zhuoming34/mmw_uav/README.md

# Fast mmWave RF 3D-object reconstruction in Low-Visibility Environment via UAV Platform
2020-2021 Senior Design Project @UMB

### Texas Instruments mmWave Training Series
- https://training.ti.com/mmwave-training-series
