zhuoming34/mmw_uav/Hardware design/PCB/README.md

## Crazyflie v2 Template
crazyflie2-exp-template-electronics-master.zip

## 2019-2020 senior design PCB: flow deck connector
flow2_repin_gerber.zip

## 2020-2021 senior design PCB: multiranger deck connector
cf2-multirgr-connector-single.zip

## Mouser Library Loader for KiCAD
LibraryLoaderSetup2v49.msi.zip

## Wuerth FFC connector 8-pin 0.5mm footprint
Wuerth FFC connector 8pins 0.5mm/687108183722-pcb-part-libraries.zip
[https://www.mouser.com/ProductDetail/Wurth-Elektronik/687108183722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]

## Wuerth FFC jumper cable
[https://www.mouser.com/ProductDetail/Wurth-Elektronik/687608200002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]
