zhuoming34/mmw_uav/Scripts/Sample Synthesizer/README.md

# Sample Generator
- functions folder
- main.m
- variable_library.m
- variable_library_radar.m
- variable_camera.m

## main.m
## variable_library.m
## variable_library_radar.m
## variable_camera.m
