zhuoming34/mmw_uav/Scripts/CAD/README.md

# CAD Models
Showing 10 out of 38 CAD car models provided by Hawkeye.
The rest 28 CAD models can be found here: 
https://github.com/JaydenG1019/HawkEye-Data-Code
