zhuoming34/mmw_uav/Documentations/Algorithms/CFAR.pptx

## CFAR Constant False Alarm Rate Detection

08/27/2020

## Motivation

- Want to receive the reflected signals from targets, instead of clutter (environment and unwanted objects: ground, rain, buildings, trees, etc.)
- Want a dynamic threshold to filter out signals from clutters.
- By maintaining the threshold to have a constant false alarm rate (probability of false alarm) P_(fa)

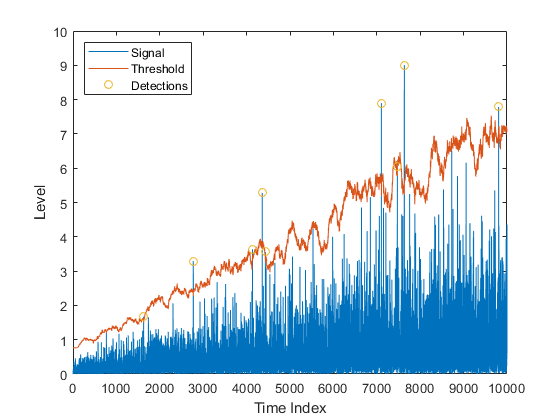
[picture p33: figure]

## Schematics

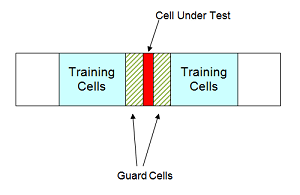
[picture p34: figure]
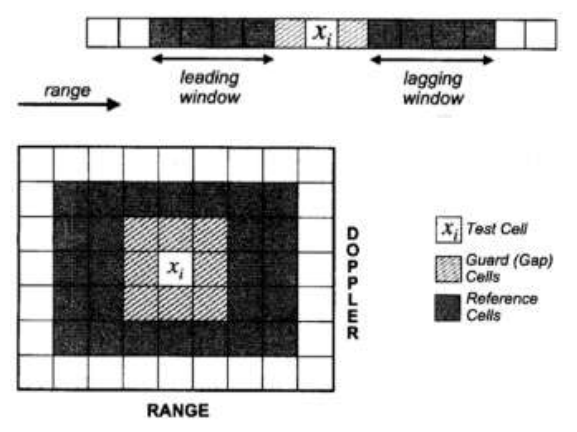
[picture p35: figure]

## Implementation

T = number of training cells on one side
G = number of guard cells on one side

1. Define number of training cells and guard cells
2. Sling the window one cell at a time across the complete FFT 1D array.
( total window size = 2*( T + G ) + 1 )
3. Sum the signal (noise) within all training cells
4. Average the sum above to determine the noise power estimate
5. Scale the noise estimate with an appropriate threshold factor to get a threshold
6. Measure signal in CUT (at T + G +1)
7. Compare against the threshold

## Equations

The detection threshold:
T=aP_n
where P_n is the noise power estimate,
a is the threshold factor, a function of fasle alarm rate P_(fa)
P_n =1/N∑_(m=1)^N x_m
where N is the number of training cells, x_m is the sample in each training cell.
Assuming the data passed into the detector is from a single pulse (i.e. no pulse integration), then the threshold factor:
a=N(P_(fa)^(−1/N) −1)

## phased.CFARDetector

- Assuming it is a square law detector with white Gaussian noise
- Important properties:
  - NumGuardCells
  - NumTrainingCells
  - Threshold factor
  - ProbabilityFalseAlarm
  - NumDetections
- Y = H(X,cutidx)
- [Y, TH] = H(X,cutidx)
  - X = input data, either a Mx1 column vector or MxN matrix
  - Cutidx = a length-D vector of indices of CUT
  - Y = detection results
  - TH = threshold

## Example

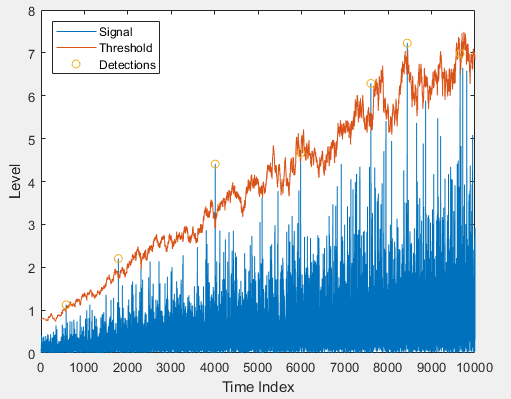
[picture p36: figure]
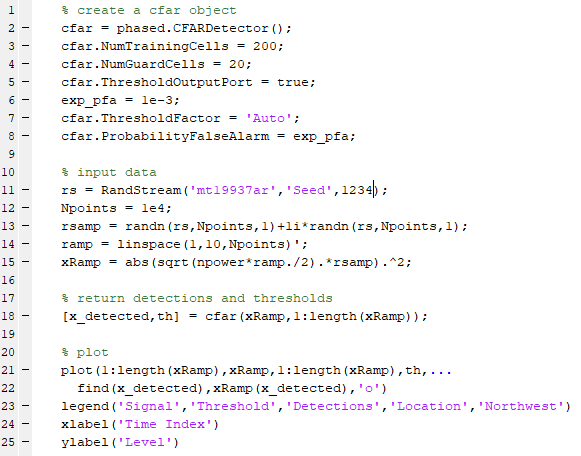
[picture p37: figure]
