zhuoming34/mmw_uav/Documentations/TI's mmWave/mmWave_Studio_Basic_Configurations.pdf

# Tutorial of Basic Configurations in Texas Instrument’s mmWave Studio with DCA1000EVM and IWR6843ISK

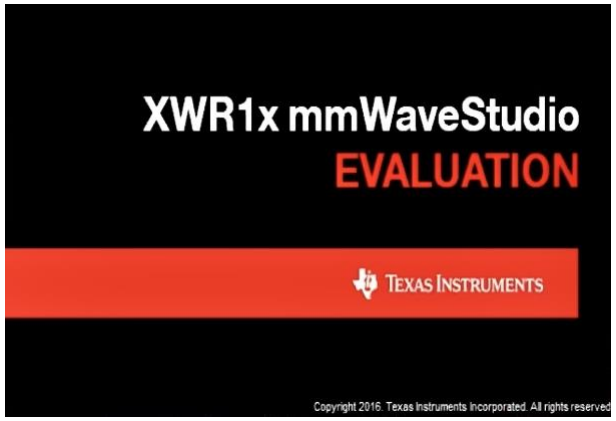
[picture p89: figure]

Detailed requirements and setups refer to the following video: DCA1000 Training Video : https://training.ti.com/dca1000-training-video Video for following steps: https://youtu.be/6t-P8zM8yU4

- Step A: Connection [Figures 1-6]
Follow the color-coded and numbered buttons to set up the connections
1. Reset control
2. Connect COM port for RS232 operations
3. Load BSS firmware
4. Load MSS firmware
5. SPI Connect
6. RF Power-up
- Step B: Static Configuration (StaticConfig) [Figures 7-9]
1. Select Tx2 (the 3rd transmitter) for IWR6843ISK to use MIMO configuration in azimuth direction
2. Set basic configuration
3. Set advanced configuration (default settings)
4. Click RF Init button (changes to RF Init Done after clicking it)
- Step C: Data Configuration (DataConfig) [Figures 10-12]
1. Set data path configuration (default settings)
2. Set clock configuration (default settings)
3. Set data configuration (default settings)
- Step D: Sensor Configuration (SensorConfig) [Figures 13-19]
1. In Profile section, change the Sample Rate (ksps) to 2047 and Ramp End Time (μs) to 133 (so that Bandwidth=3987.61MHz for a range resolution ≅ 4cm), then Set
2. In Chirp section, select Tx0 only with Start Chirp 0 and End Chirp 0, then Set
3. In Chirp section, select Tx1 only with Start Chirp 1 and End Chirp 1, then Set
4. In Chirp section, select Tx2 only with Start Chirp 2 and End Chirp 2, then Set
5. In Frame section, Start Chirp TX 0 and End Chirp TX 2 for TDM MIMO configuration. Set up desire number of chirps and frames with appropriate frame periodicity.

DutyCycle =

CℎirpDuration ∗ NumCℎirp ∗ NumTx

| FramePeriodicity | = (IdleTime + RampEndTime) ∗ NumCℎirp ∗ NumTx
| | FramePeriodicity
Example:
Idle Time = 100 μs, | Ramp End Time = 133 μs, | Periodicity = 180 ms
Number of Transmitters = 3 (Tx0, Tx1, Tx2), | Number of Chirp(No of Chirp Loops) = 128,
| DutyCycle =

(100μs + 133μs) ∗ 128 ∗ 3
| | 180ms ≅ 49.7%
6. At the left-most section, click the Set Up DCA1000 button to open the RFDataCaptureCard window
7. Click the Connect, Reset and Configure button to setup the DCA100EVM
- Step E: Data Capture and Post Processing (SensorConfig – Capture and Post Processing Section) [Figures 20-22]
1. Browser and select the .bin file to save captured data
2. DCA100 ARM
3. Trigger Frame
4. PostProc (post processing)

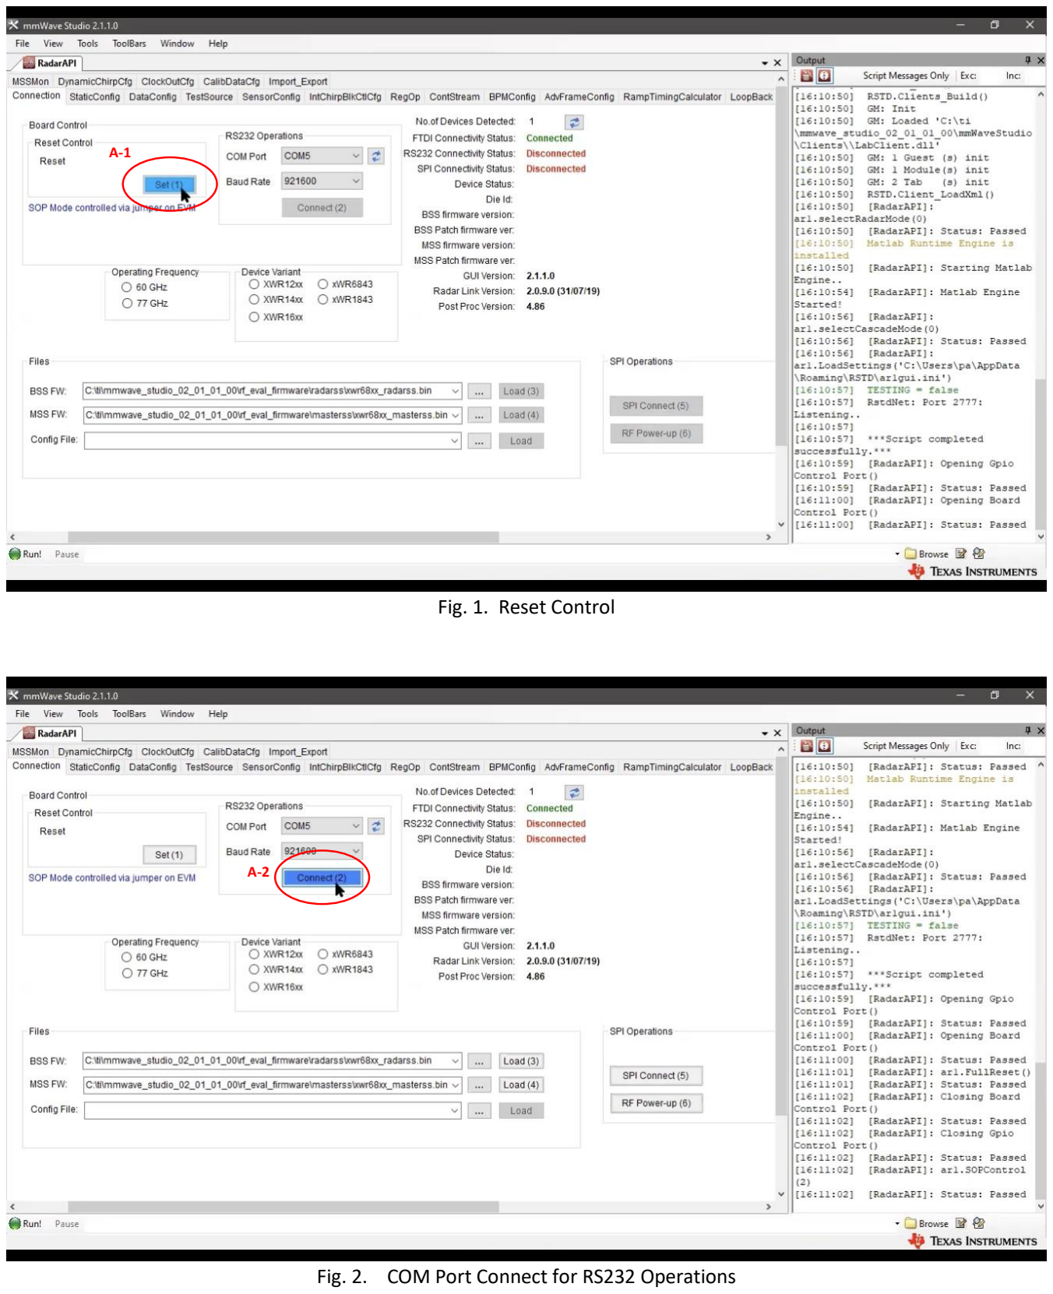
[picture p90: page 3]

Fig. 1. Reset Control

Fig. 2. COM Port Connect for RS232 Operations

A-1

A-2

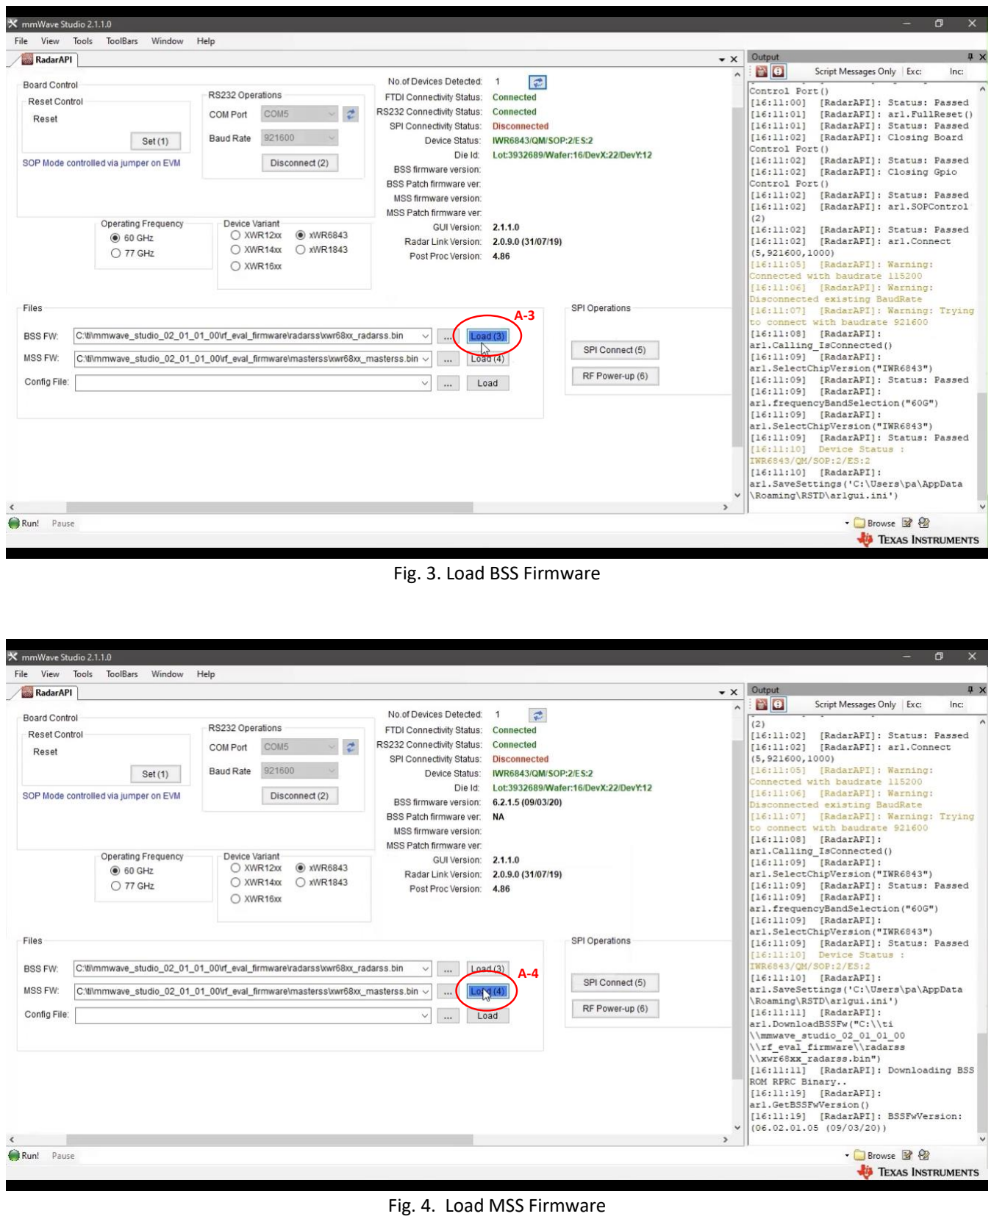
[picture p91: page 4]

Fig. 3. Load BSS Firmware

Fig. 4. Load MSS Firmware

A-3

A-4

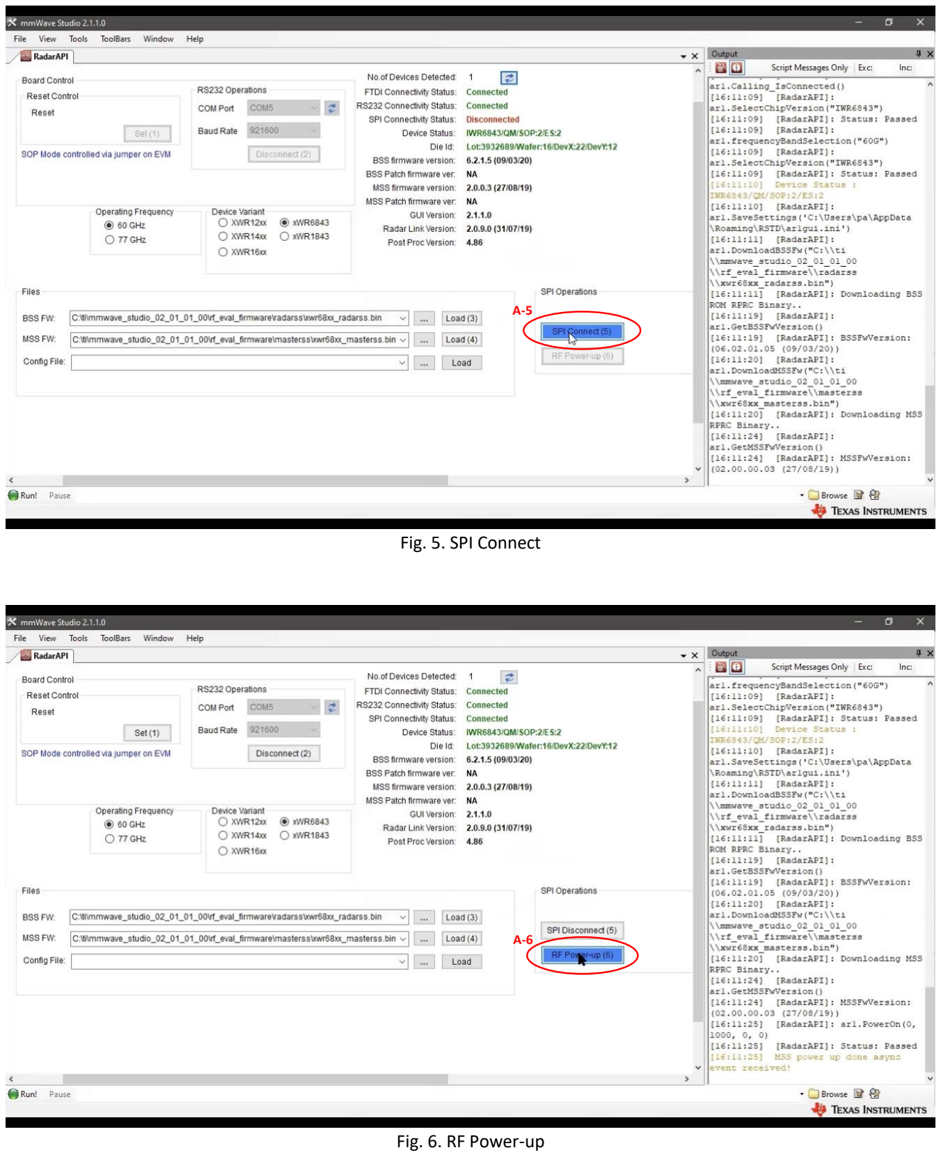
[picture p92: page 5]

Fig. 5. SPI Connect

Fig. 6. RF Power-up

A-5

A-6

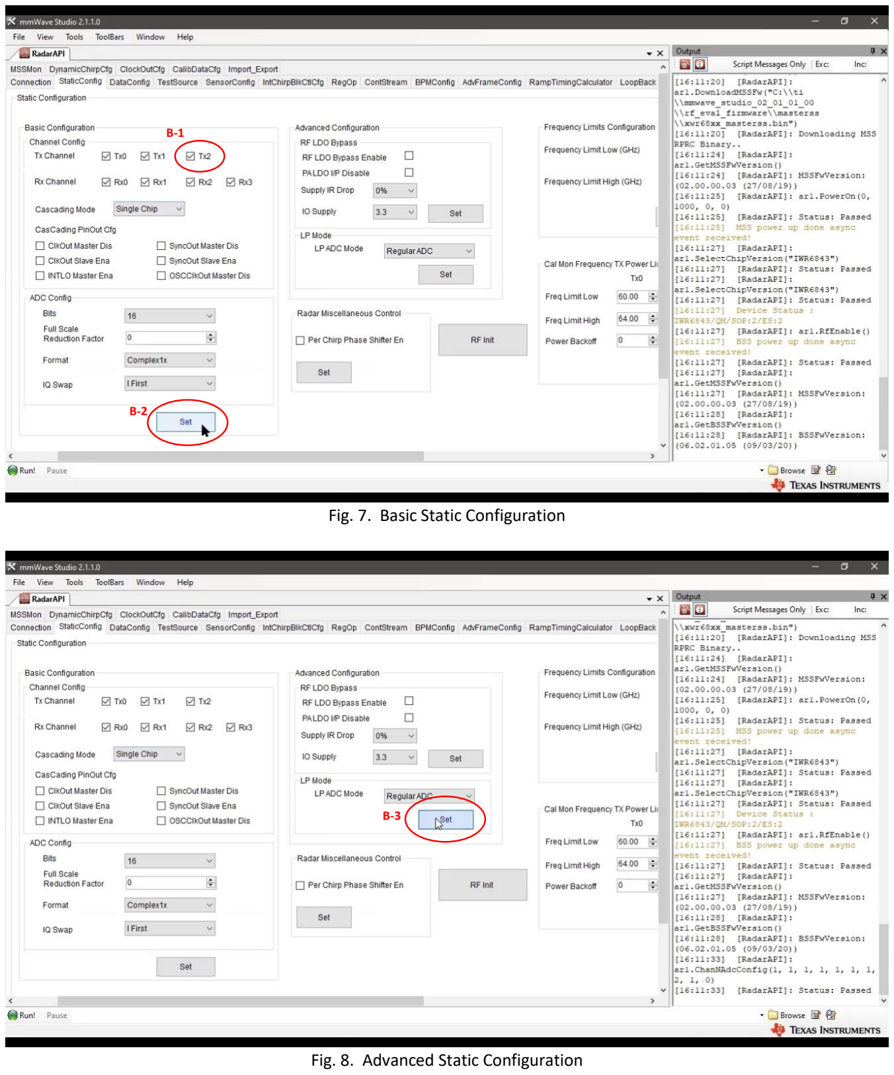
[picture p93: page 6]

Fig. 7. Basic Static Configuration

Fig. 8. Advanced Static Configuration

B-1

B-2

B-3

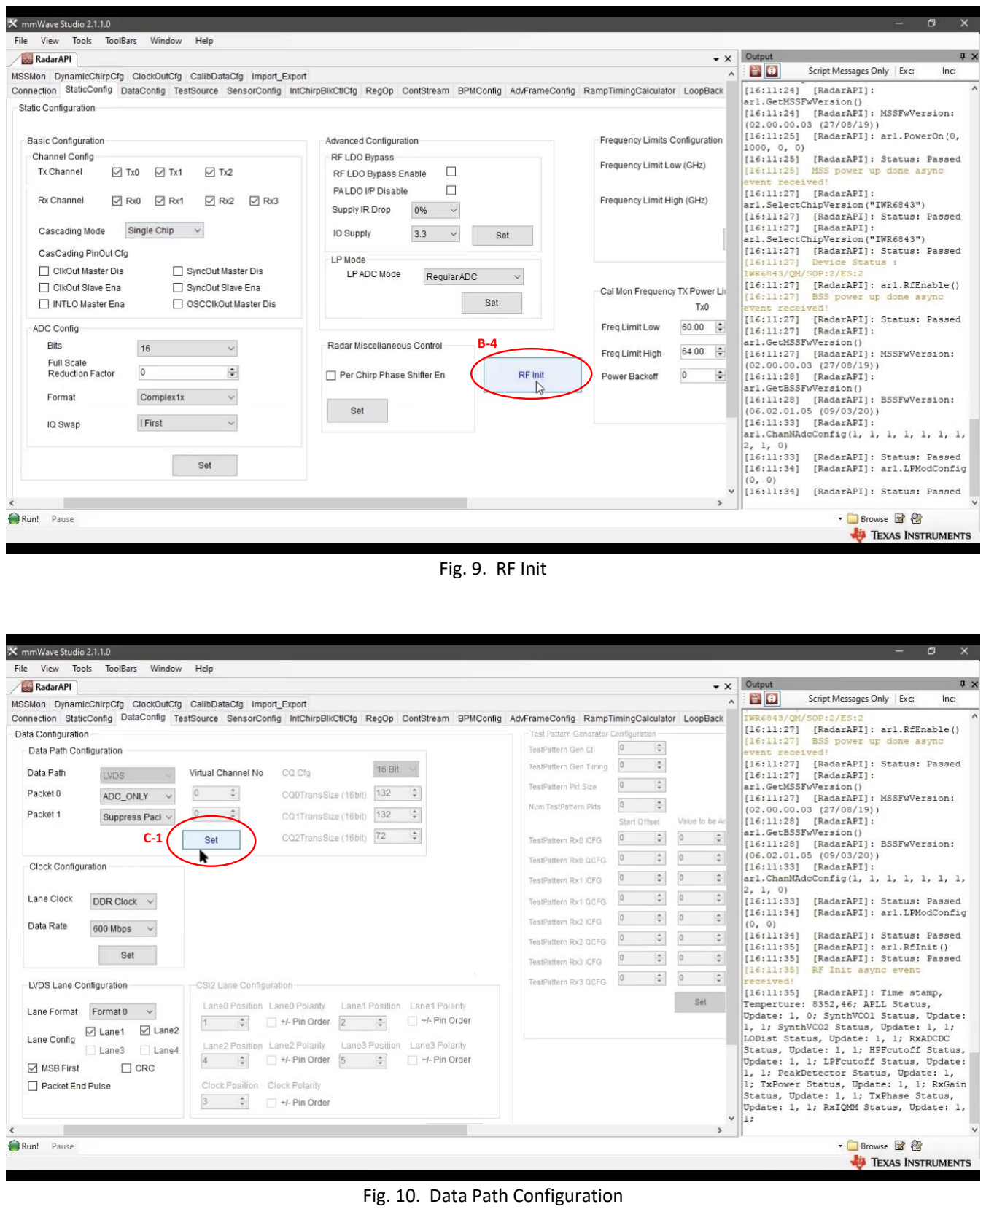
[picture p94: page 7]

Fig. 9. RF Init

Fig. 10. Data Path Configuration

B-4

C-1

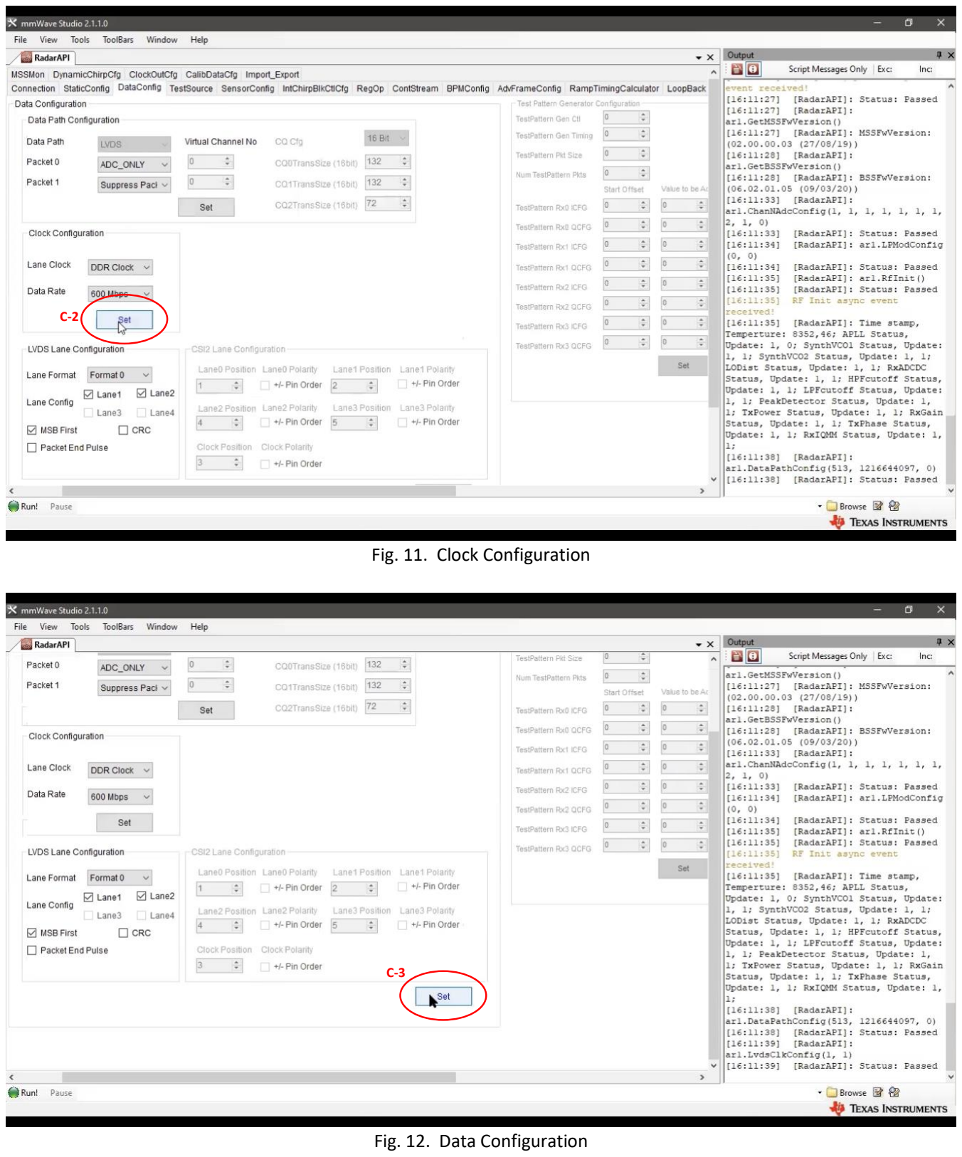
[picture p95: page 8]

Fig. 11. Clock Configuration

Fig. 12. Data Configuration

C-2

C-3

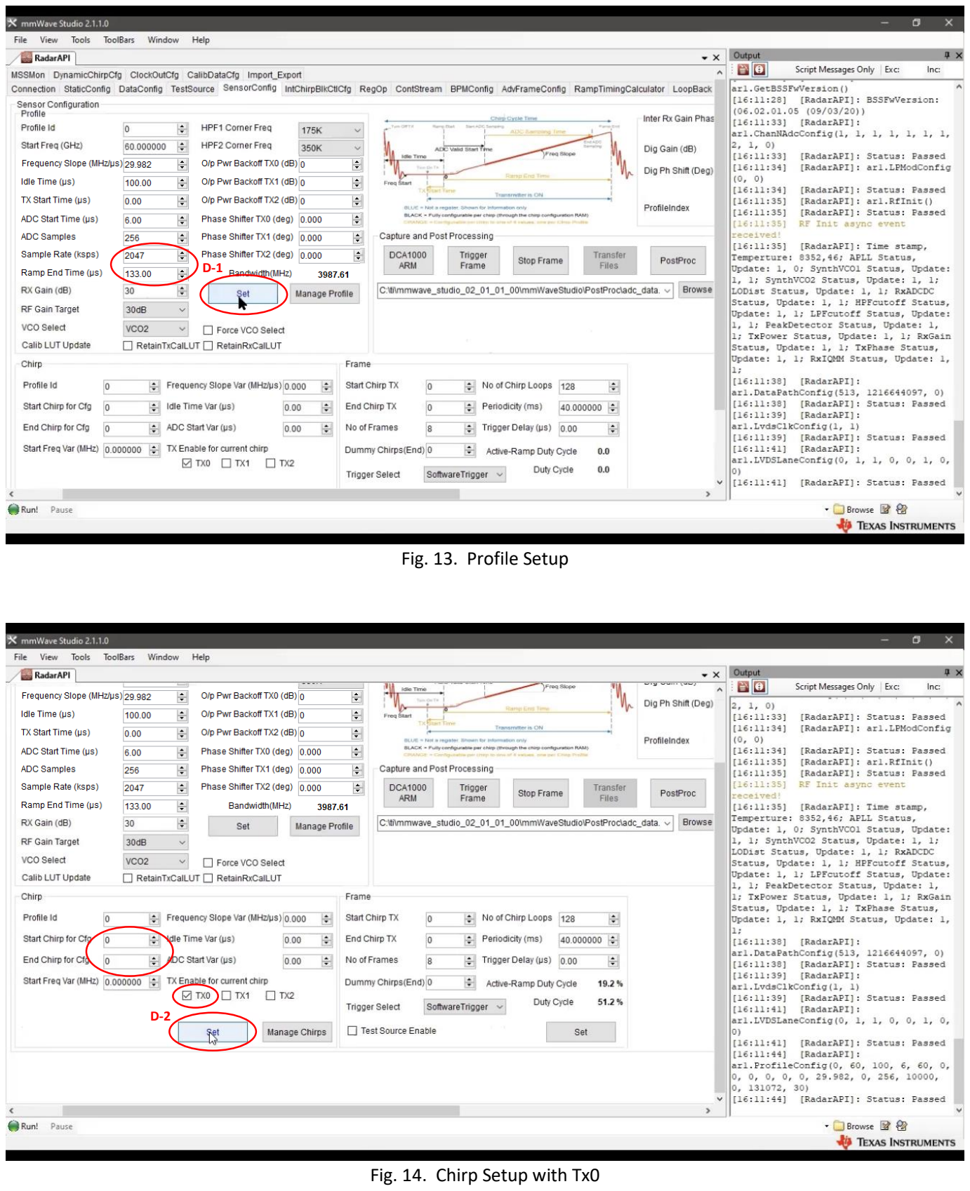
[picture p96: page 9]

Fig. 13. Profile Setup

Fig. 14. Chirp Setup with Tx0

D-1

D-2

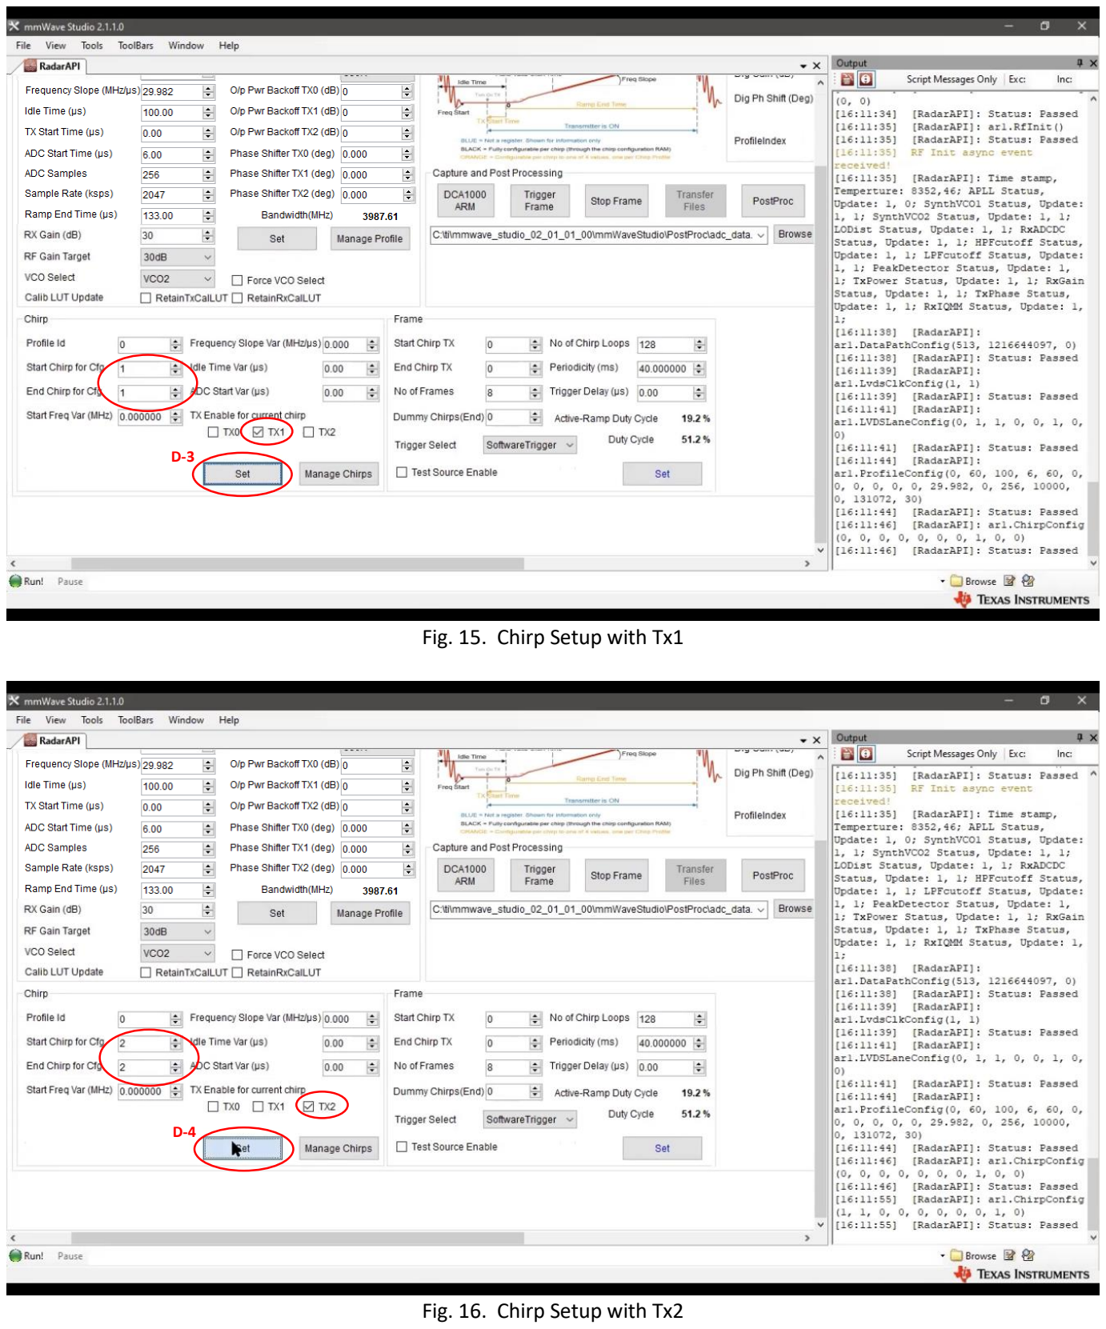
[picture p97: page 10]

Fig. 15. Chirp Setup with Tx1

Fig. 16. Chirp Setup with Tx2

D-3

D-4

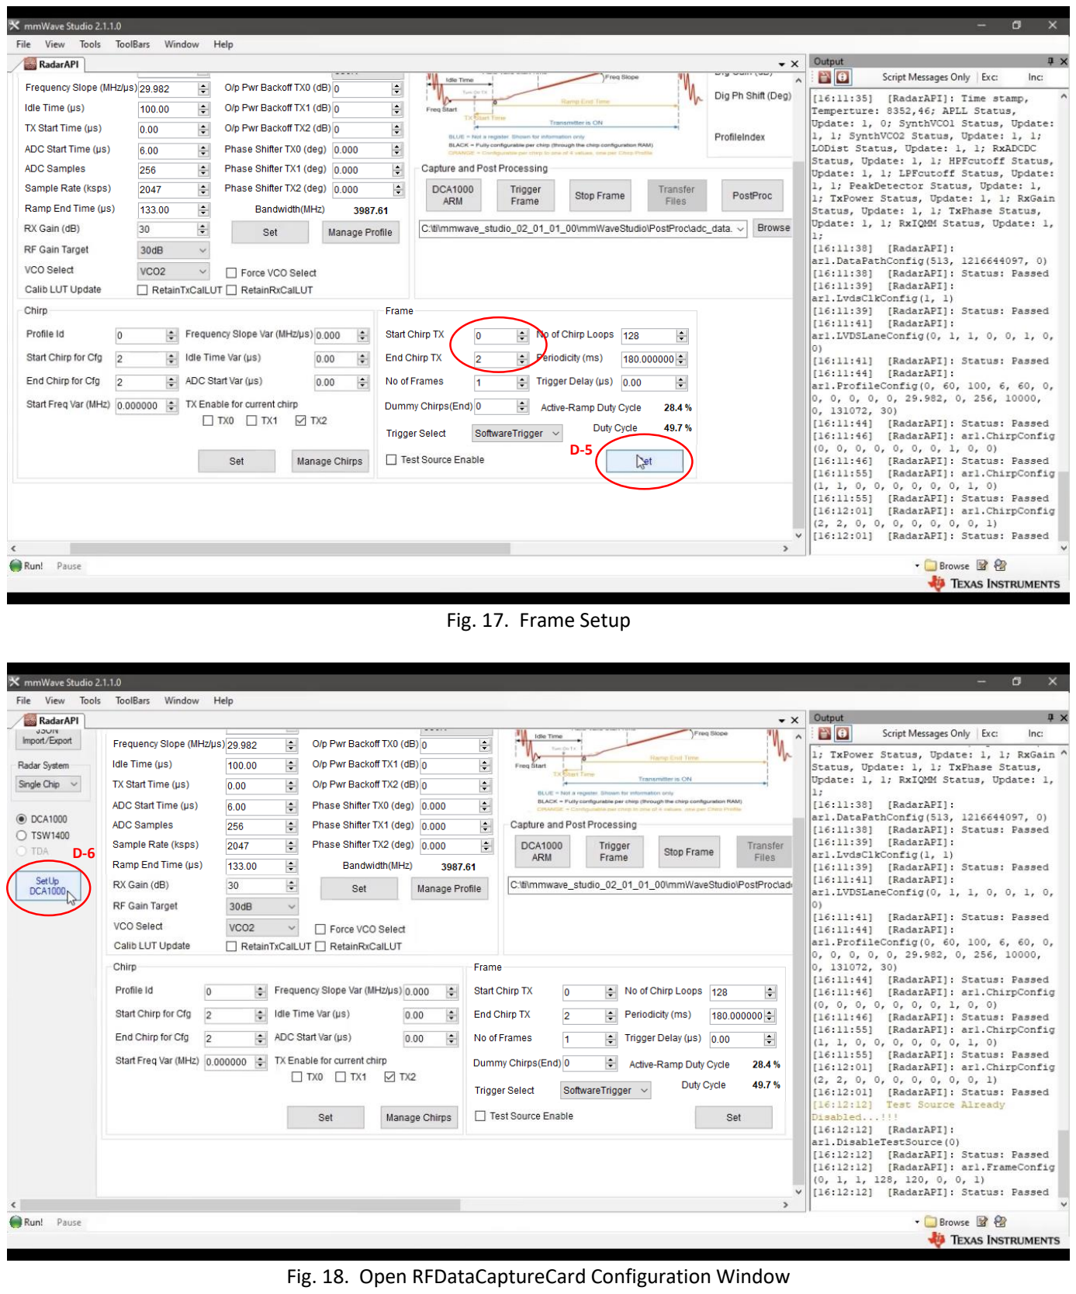
[picture p98: page 11]

Fig. 17. Frame Setup

Fig. 18. Open RFDataCaptureCard Configuration Window

D-5

D-6

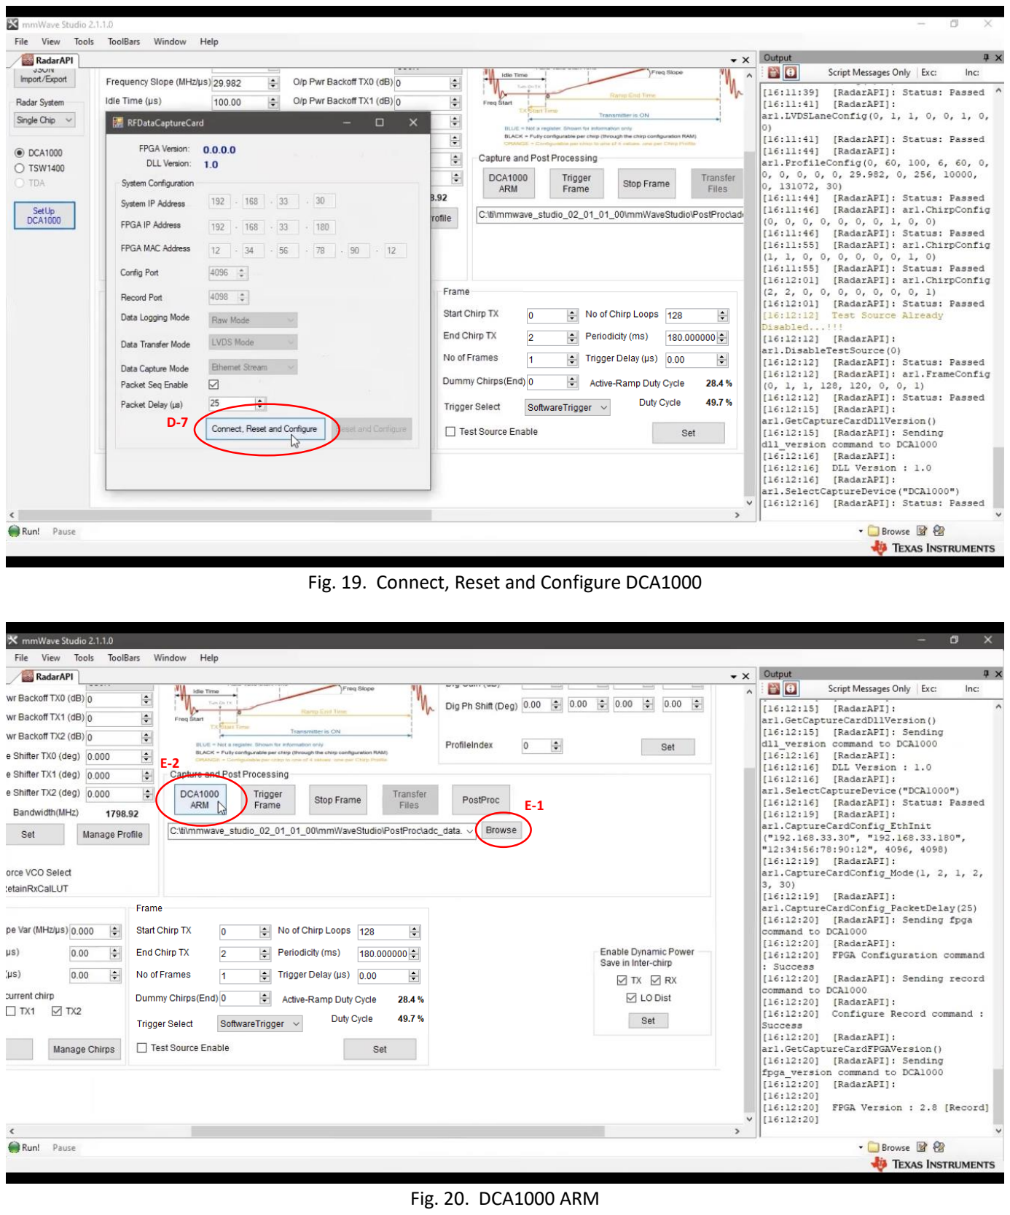
[picture p99: page 12]

Fig. 19. Connect, Reset and Configure DCA1000

Fig. 20. DCA1000 ARM

D-7

E-1

E-2

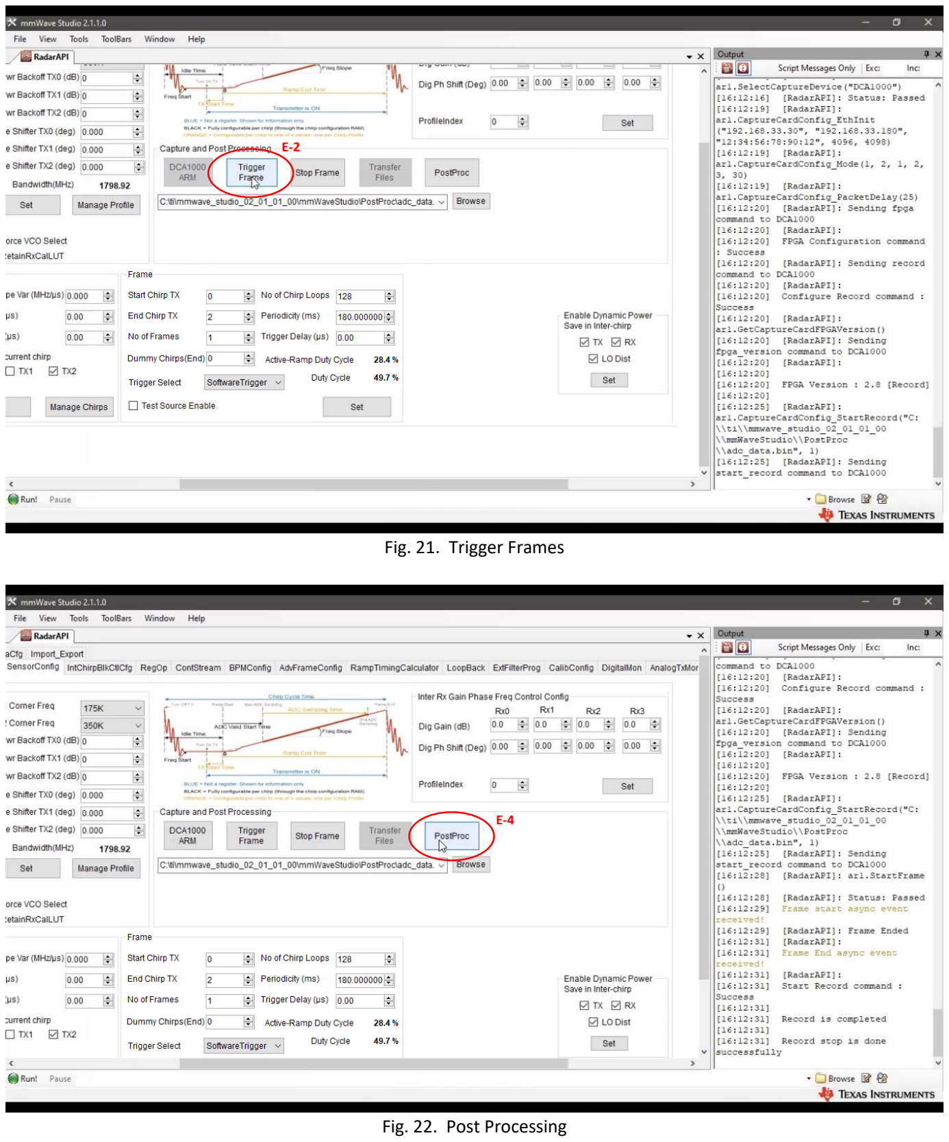
[picture p100: page 13]

Fig. 21. Trigger Frames

Fig. 22. Post Processing

E-2

E-4
