zhuoming34/mmw_uav/Documentations/Meeting Notes/ENGIN492/week#3_0210.pdf

ENGIN492, Senior Design Weekly Meeting #3

Meeting Minutes
02/10/2021 | 15:30 – 16:00
CM/TM: | Dr. Honggang Zhang
Students: | Zhuoming Huang, Alinson Sanquintin, Lucas Lomba
- Agenda
1. Confirming DIY slides Design
- Notes
1. Radar calibration
2. 3D prints for the customized slider (order it from Maker Space ASAP, forward the notices to Prof. Zhang)
3. PCB design and order (confirm with Lucas)
- Follow-up
