zhuoming34/mmw_uav/Documentations/Meeting Notes/ENGIN492/week#9_0324.pdf

ENGIN492, Senior Design Weekly Meeting #9

Meeting Minutes
03/24/2021 | 15:30 – 16:10
CM/TM: | Dr. Honggang Zhang
Students: | Zhuoming Huang, Alinson Sanquintin
- Agenda
1. Verification tests (continued)
- Notes
1. 3D point cloud given by depth camera is not accurate all the time, we may use accurate measurement of distance by the radar sensor.
2. Conduct drone stabilization test outdoor, followed by flight control accuracy test indoor.
- List of Actions
- Preliminary Agenda for Next Meeting
