zhuoming34/mmw_uav/Documentations/Meeting Notes/ENGIN491/week#16_minutes_1221.pdf

Senior Design Weekly Meeting #16

Meeting Minutes
12/21/2020 | 13:30 – 14:45
CM/TM: | Dr. Honggang Zhang
Students: | Zhuoming Huang, Yue Sun, Alinson Sanquintin, Lucas Lomba
- Agenda
1. CAD modeling tools
- Notes
1. Research on FreeCAD
a. representing/converting CAD models in the form of point-cloud
b. https://www.freecadweb.org/
2. Winter break
a. Resuming meetings on 1/4/2021, 1pm
