zhuoming34/mmw_uav/Documentations/Meeting Notes/ENGIN491/week#4_notes.pdf

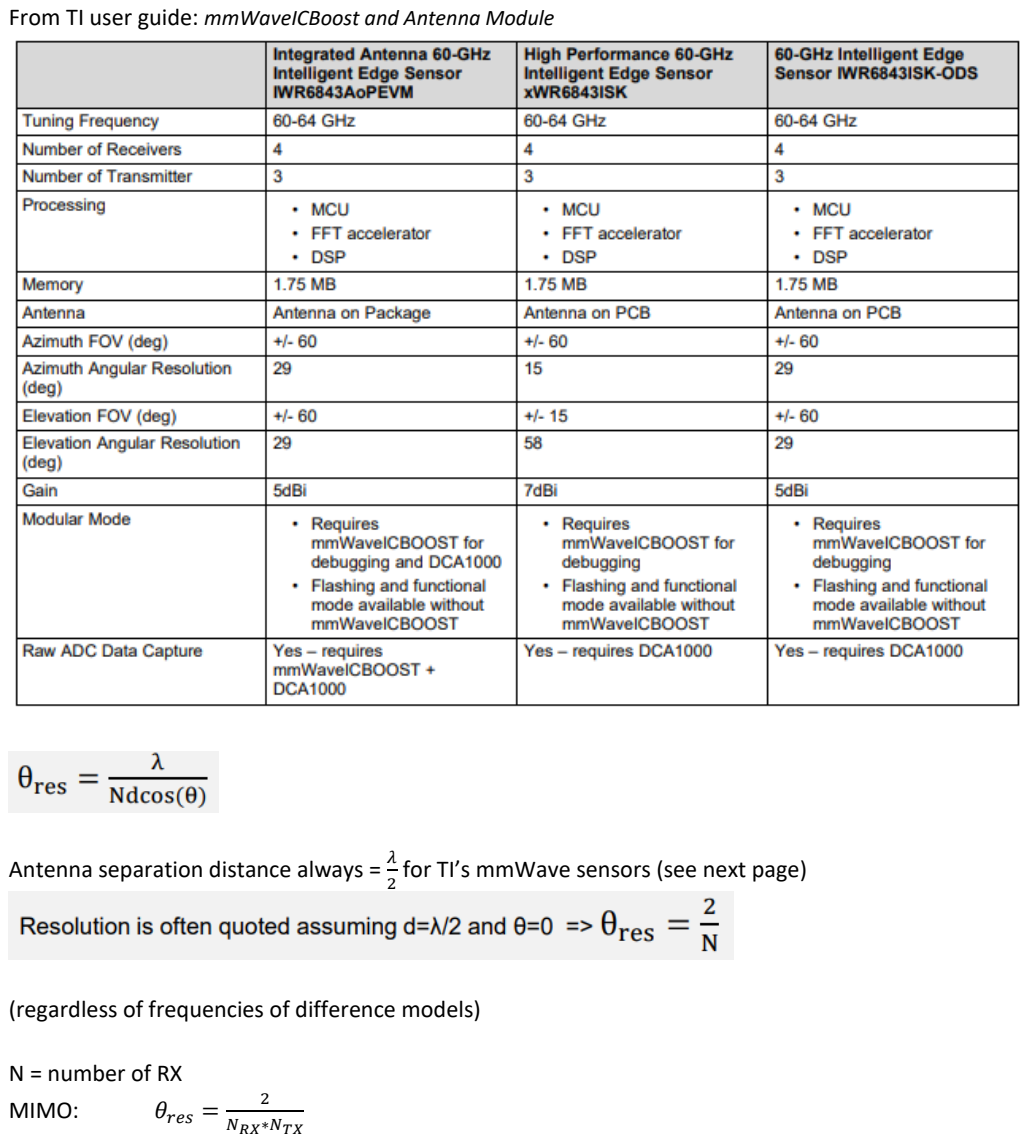
[picture p103: page 1]

From TI user guide: mmWaveICBoost and Antenna Module

Antenna separation distance always = λ
2

for TI’s mmWave sensors (see next page)

(regardless of frequencies of difference models)

N = number of RX
MIMO: | θres =

2

NRX∗NTX

(

(

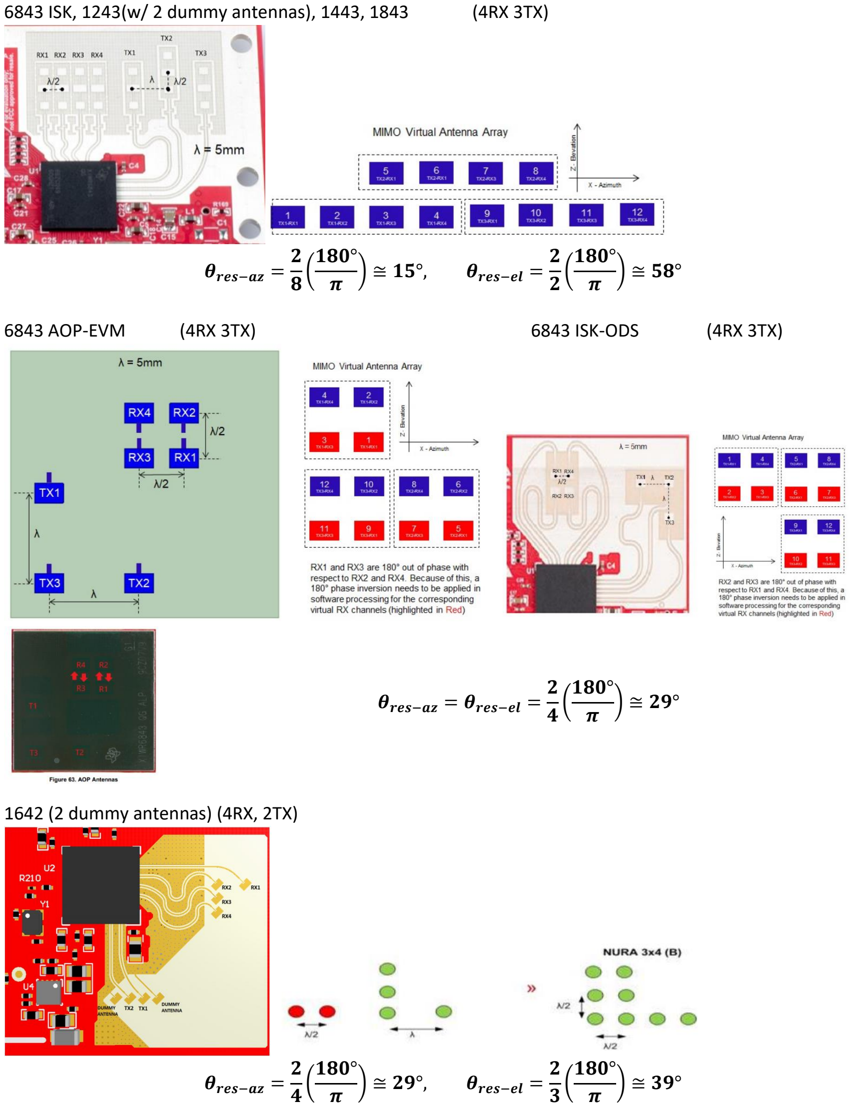
[picture p104: page 2]

6843 ISK, 1243(w/ 2 dummy antennas), 1443, 1843 | (4RX 3TX)

θres−az =

2
8

180°
π

) ≅ 15°, θres−el =

2
2

180°
π

) ≅ 58°

6843 AOP-EVM | (4RX 3TX) | 6843 ISK-ODS | (4RX 3TX)

θres−az = θres−el =

2
4

(

180°
π

) ≅ 29°

1642 (2 dummy antennas) (4RX, 2TX)

θres−az =

2
4

(

180°
π

) ≅ 29°, θres−el =

2
3

(

180°
π

) ≅ 39°
