zhuoming34/mmw_uav/Documentations/Algorithms/Root-MUSIC.pptx

## Root-MUSIC, Range, and Doppler Estimations

09/01/2020

## MATLAB Objects and Functions

- Phase Array System Toolbox:
  - Objects/classes:
    - phased.RootMUSICEstimator
    - phased.RangeDopplerResponse
    - phased.RangeEstimator
    - phased.DopplerEstimator
- Signal Processing Toolbox
  - Function:
    - rootmusic()

## phased.RootMUSICEstimator

- Multiple Signal Classification DoA Estimation
- Properties
  - Important:
    - SensorArray: ULA (or UCA)
    - PropagationSpeed: speed of light or user specified
    - OperatingFrequency: central frequency of radar fc
    - NumSignalsSource: ‘Property’
    - NumSignals: #signal received by ULA (default: 1)
  - Others:
    - NumSignalsMethod: ‘AIC’ or ‘MDL’ (Akaike Information Criterion or Minimum Description Length Criterion)
    - SpatialSmoothing: 0
    - ForwardBackwardAveraging: false

## phased.RootMUSICEstimator

- H = phased.RootMUSICEstimator()
- ANG = H(x)
  - For ULA use
  - Estimates the direction of arrival (DOA’s) from a signal x
  - X is a matrix whose columns correspond to the signal channels.
  - ANG is a row vector of estimated broadside angles in degrees.
- ANG = H(x, ElAng)
  - For UCA use
  - ElAng = elevation angles of signals

## Example

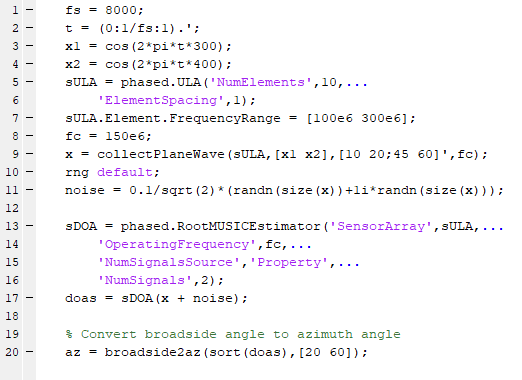
[picture p105: figure]
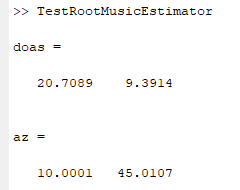
[picture p106: figure]

## phased.RangeDopplerResponse

- Calculate filtered response to range data, perform peak detection, resolve range-Doppler coupling.
- Important Properties (for FFT):
  - Range Method: FFT
  - Signal propagation speed
  - Sampling rate
  - Sweep slope
  - Range FFT Length
  - Doppler FFT Length
  - Operating Frequency
  - Doppler Output: frequency or Speed
- [resp,rnggrid,dopgrid] = H(x)
- plotResponse(H,x)

## phased.RangeEstimator

- Important Properties:
  - RMS Resolution
  - Noise Power source: ‘input port’ to enable input to step functions
  - Cluster Input Port: true to enable input
  - Variance output port: true to enable output

## phased.RangerEstimator

- H = phased.RangerEstimator()
- rngest = H(resp,rnggrid,detidx)
- [rngest,rngvar] = H(resp,rnggrid,detidx,noisepower)
- [rngest,rngvar] = H(resp,rnggrid,detidx,clusterids)
- [rngest,rngvar] = H(resp,rnggrid,detidx,clusterids,noisepower)
- rnggrid = units for range dimension of the response data cube
- detidx = detection position index

## phased.DopplerEstimator

- Important Properties
  - Num pulses: number of pulses in doppler-processed waveform
  - Noise power source
  - Cluster Input port
  - Variance output port

## phased.DopplerEstimator

- H = phased.DopplerEstimator()
- dopest = H(resp,dopgrid,detidx)
- [dopest,dopvar] = H(resp,dopgrid,detidx,noisepower)
- [dopest,dopvar] = H(resp,dopgrid,detidx,clusterids)
- [dopest,dopvar] = H(resp,dopgrid,detidx,noisepower,clusterids)

## Example

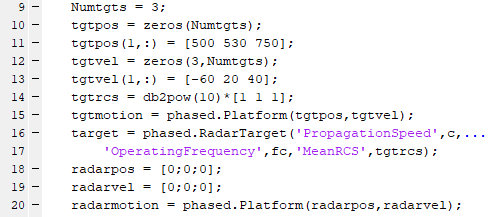
[picture p107: figure]
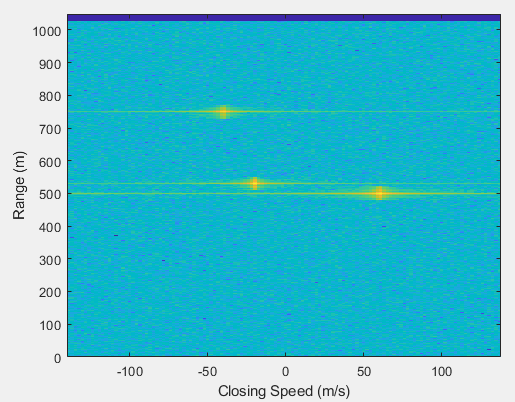
[picture p108: figure]
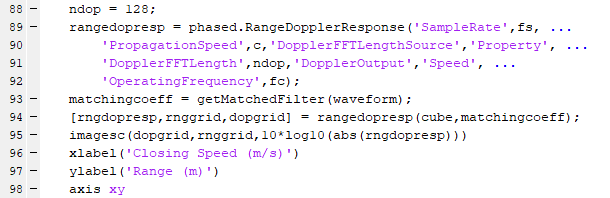
[picture p109: figure]

## Example

## rootmusic()

- w = rootmusic(x,p)
- [w,pow] = rootmusic(x,p)
- [w,pow] = rootmusic(___,'corr')
- [f,pow] = rootmusic(___,fs)
- Inputs:
  - X = input signal
  - P = dimension of signal subspace
  - Fs = sampling frequency
- Outputs:
  - a vector of frequencies, w (rad/sample) or f (Hz)
  - and a vector of correspond signal power, pow
