zhuoming34/mmw_uav/Hardware design/3D Prints/drone_frame_part5.stl

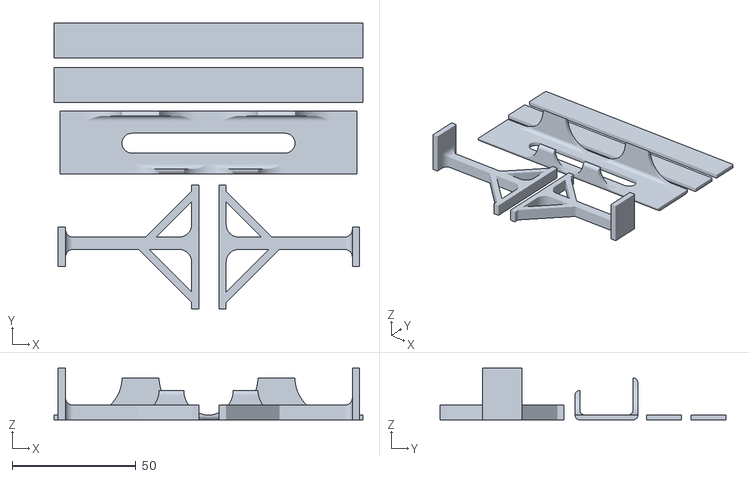
[picture p110: CAD file, 2021-02-22]
Hardware design/3D Prints/drone_frame_part5.stl
125.0 x 115.5 x 21.0
