zhuoming34/mmw_uav/Hardware design/3D Prints/drone_frame_part6.stl

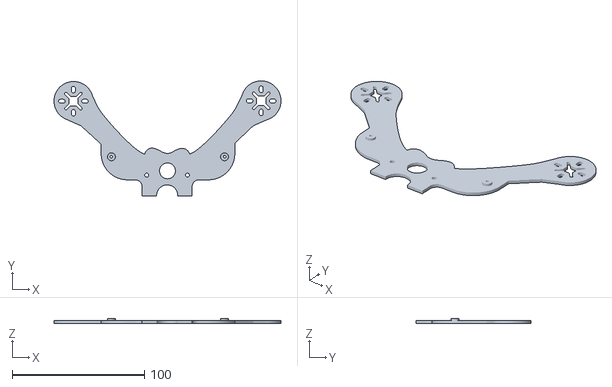
[picture p111: CAD file, 2021-02-22]
Hardware design/3D Prints/drone_frame_part6.stl
171.9 x 87.3 x 3.50
