zhuoming34/mmw_uav/Hardware design/3D Prints/drone_frame_part4.stl

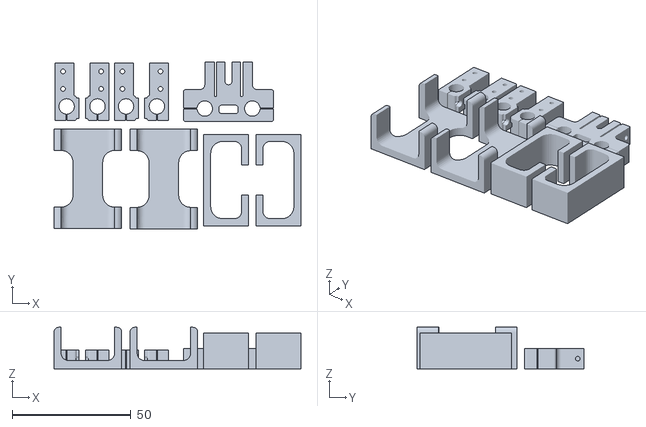
[picture p112: CAD file, 2021-02-22]
Hardware design/3D Prints/drone_frame_part4.stl
104.0 x 70.1 x 17.5
