zhuoming34/mmw_uav/Hardware design/3D Prints/drone_frame_part7.stl

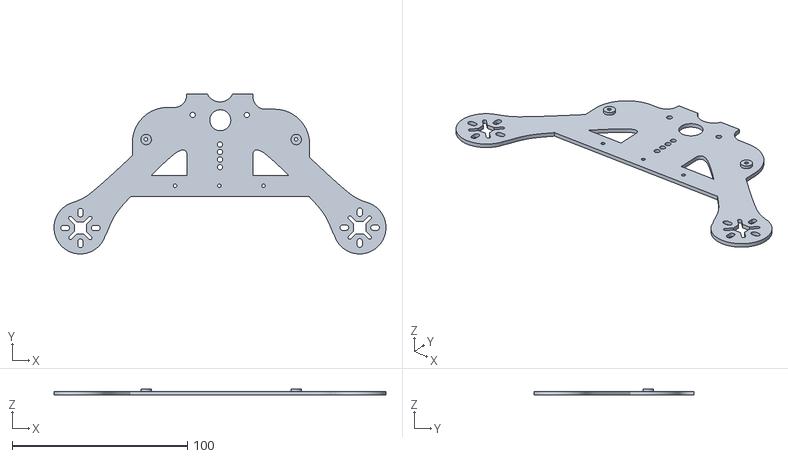
[picture p113: CAD file, 2021-02-22]
Hardware design/3D Prints/drone_frame_part7.stl
189.7 x 91.4 x 3.50
