zhuoming34/mmw_uav/Hardware design/3D Prints/drone_frame_part3.stl

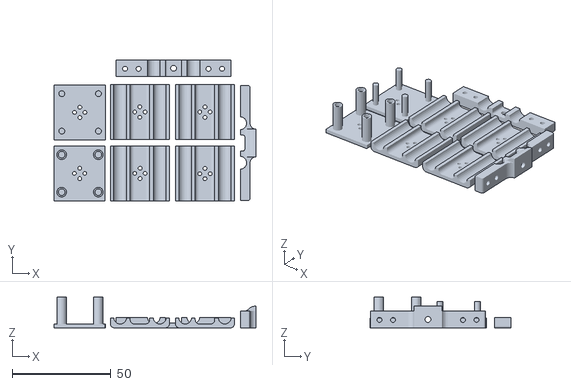
[picture p114: CAD file, 2021-02-22]
Hardware design/3D Prints/drone_frame_part3.stl
102.0 x 71.3 x 15.5
