zhuoming34/mmw_uav/Hardware design/3D Prints/drone_frame_part8.stl

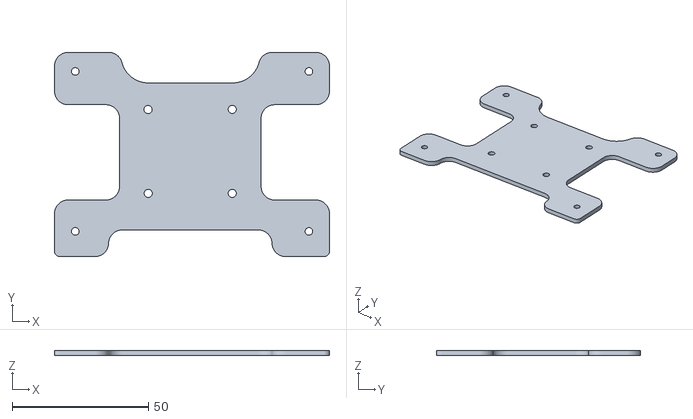
[picture p115: CAD file, 2021-02-22]
Hardware design/3D Prints/drone_frame_part8.stl
101.0 x 75.0 x 2.00
