zhuoming34/mmw_uav/Hardware design/3D Prints/drone_frame_part1.stl

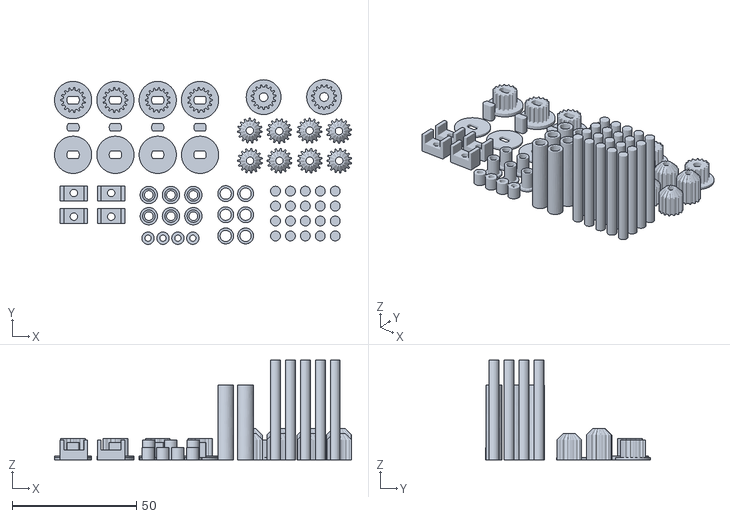
[picture p116: CAD file, 2021-02-22]
Hardware design/3D Prints/drone_frame_part1.stl
119.3 x 66.2 x 40.0
