zhuoming34/mmw_uav/Hardware design/3D Prints/drone_frame_part2.stl

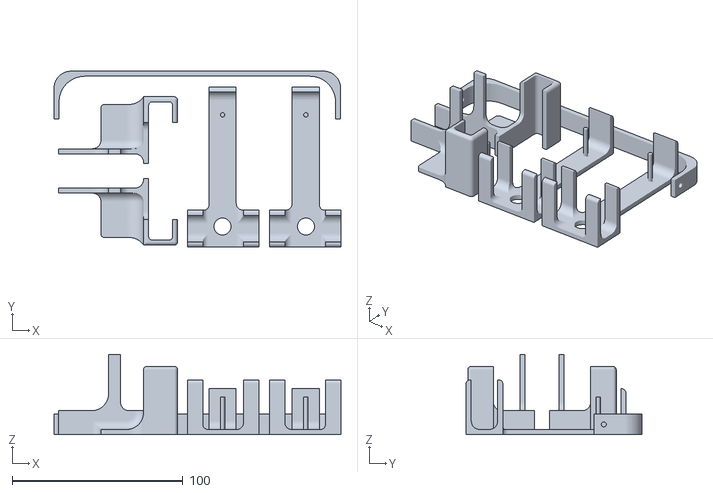
[picture p117: CAD file, 2021-02-22]
Hardware design/3D Prints/drone_frame_part2.stl
168.2 x 103.0 x 47.0
