zhuoming34/mmw_uav/Hardware design/PCB/Wuerth FFC connector 8pins 0.5mm/687108183722.stp

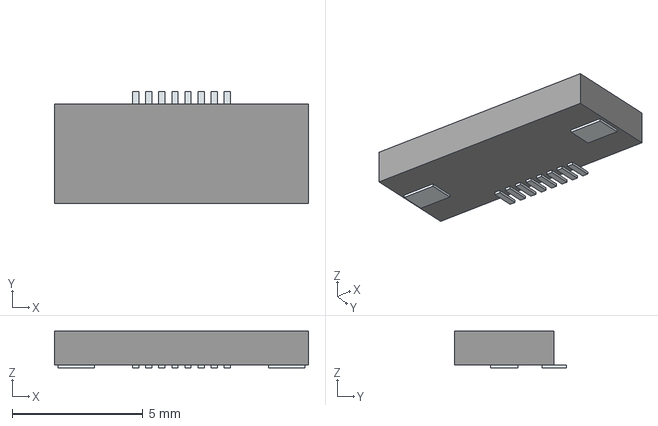
[picture p118: CAD file, 2021-06-11]
Hardware design/PCB/Wuerth FFC connector 8pins 0.5mm/687108183722.stp
9.70 x 4.27 x 1.40 mm
Pins
