zhuoming34/mmw_uav/(list of files, cad)

Other CAD files:
Hardware design/PCB/Wuerth FFC connector 8pins 0.5mm/687108183722.stl
